homalozoa/librebd1/BD1.FCStd

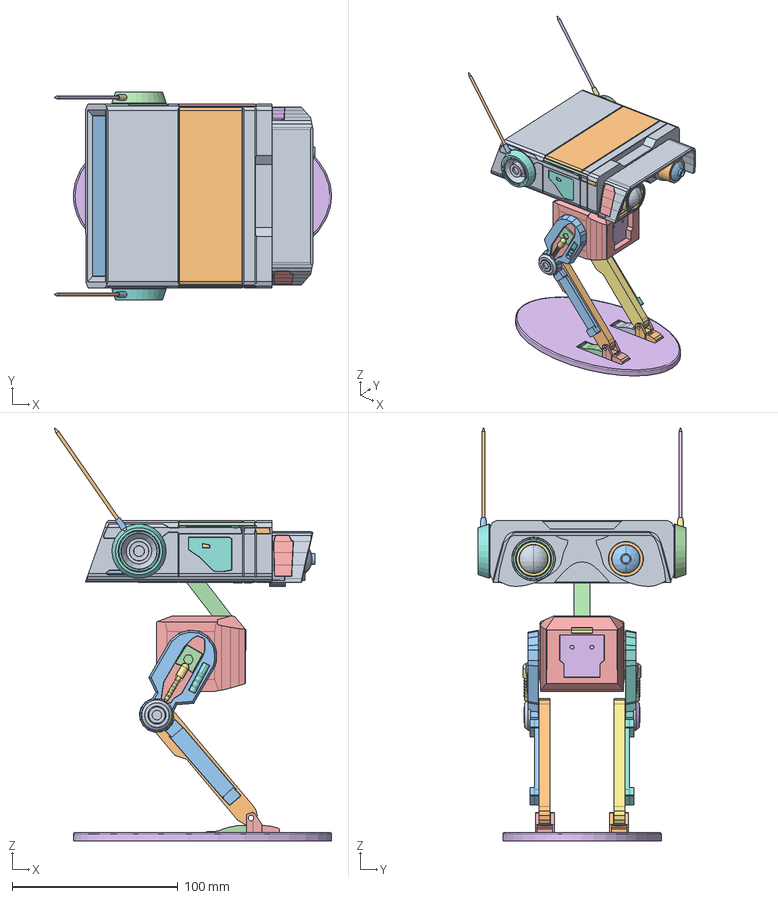
[picture p2: CAD file, 2026-10-29]
BD1.FCStd
167.5 x 125.7 x 249.4 mm
head_shell
head_top_band
head_light
paint_left_stripe
paint_left_top_edge
paint_left_hood_grey
paint_right_panel_dot
paint_right_panel
paint_right_stripe
paint_right_front_block
paint_right_back_strip
paint_right_top_edge
paint_right_snout
paint_right_hood_grey
eye_ring_right
eye_band_right
lens_right
eye_ring_left
lens_left
ear_left
ear_centre_left
antenna_left
antenna_collar_left
ear_right
ear_centre_right
antenna_right
antenna_collar_right
neck
torso
chest_plate
chest_tab
thigh_left
thigh_channel_left
thigh_channel_floor_left
thigh_channel_tip_left
thigh_rod_left
thigh_piston_left
knee_cap_left
shin_left
shin_plate_left
foot_heel_left
foot_front_left
thigh_right
thigh_channel_right
thigh_channel_floor_right
thigh_channel_tip_right
thigh_rod_right
thigh_piston_right
knee_cap_right
shin_right
shin_plate_right
foot_heel_right
foot_front_right
stand
