homalozoa/librebd1/stl/foot_front_left.stl

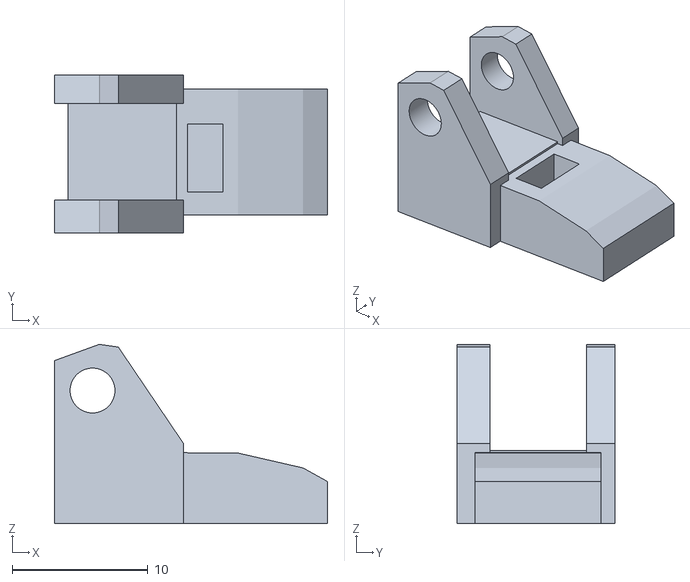
[picture p3: CAD file, 2026-10-29]
stl/foot_front_left.stl
20.1 x 11.6 x 13.2
