homalozoa/librebd1/stl/shin_plate_left.stl

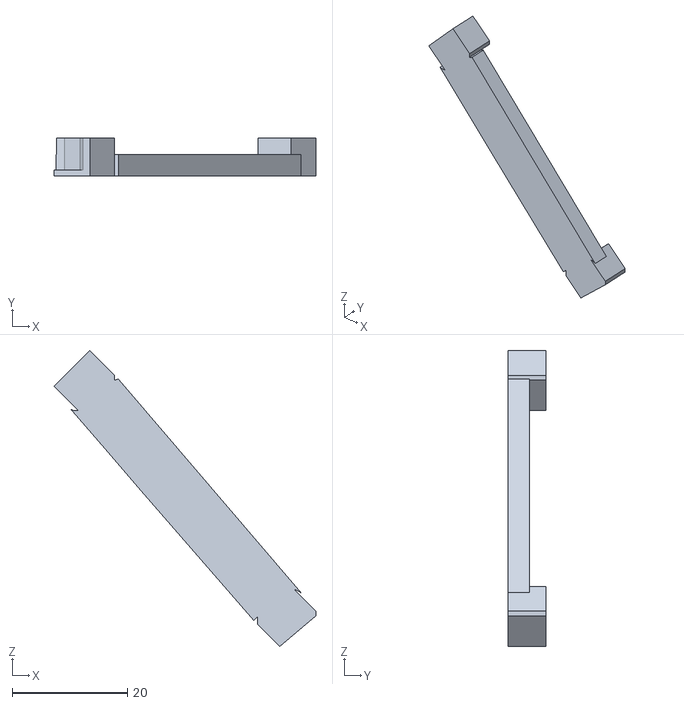
[picture p4: CAD file, 2026-10-29]
stl/shin_plate_left.stl
45.5 x 6.60 x 51.5
