homalozoa/librebd1/stl/neck.stl

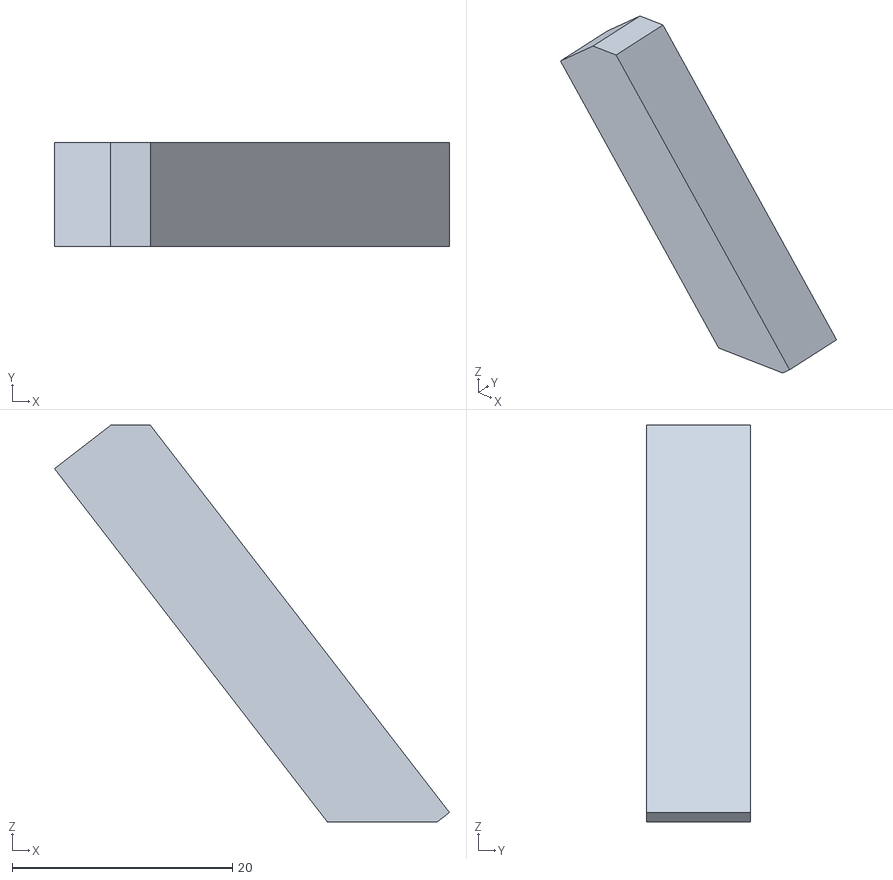
[picture p5: CAD file, 2026-10-29]
stl/neck.stl
35.9 x 9.40 x 36.0
