homalozoa/librebd1/stl/chest_plate.stl

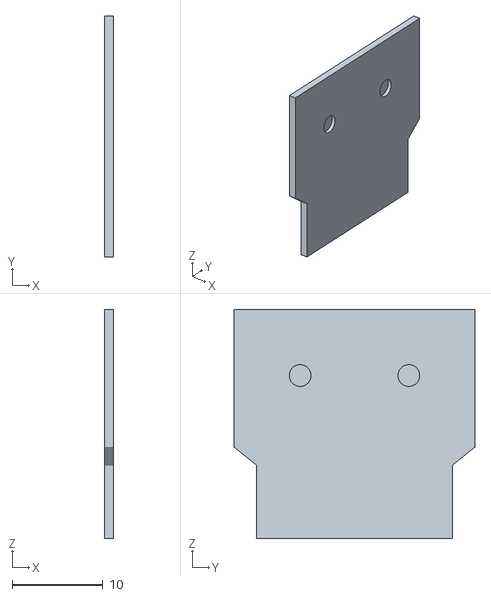
[picture p6: CAD file, 2026-10-29]
stl/chest_plate.stl
1.00 x 26.6 x 25.3
