homalozoa/librebd1/stl/eye_band_right.stl

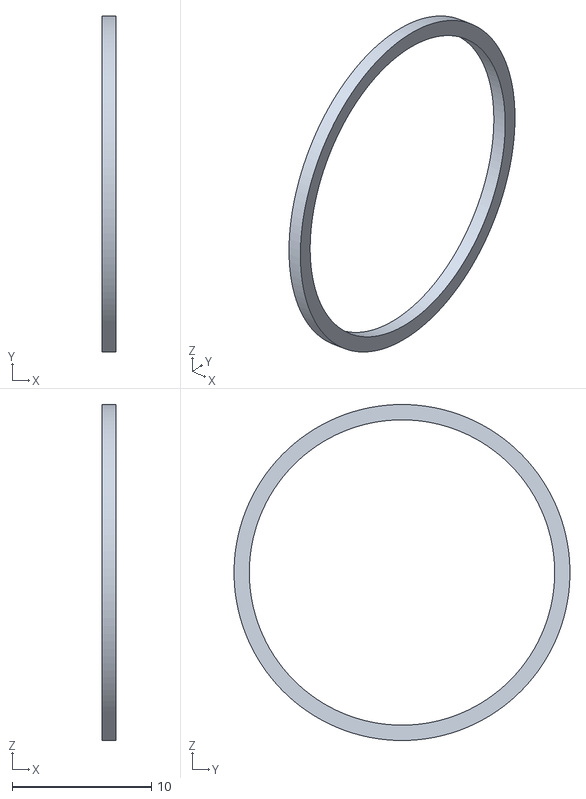
[picture p7: CAD file, 2026-10-29]
stl/eye_band_right.stl
1.00 x 24.1 x 24.1
