homalozoa/librebd1/stl/paint_left_hood_grey.stl

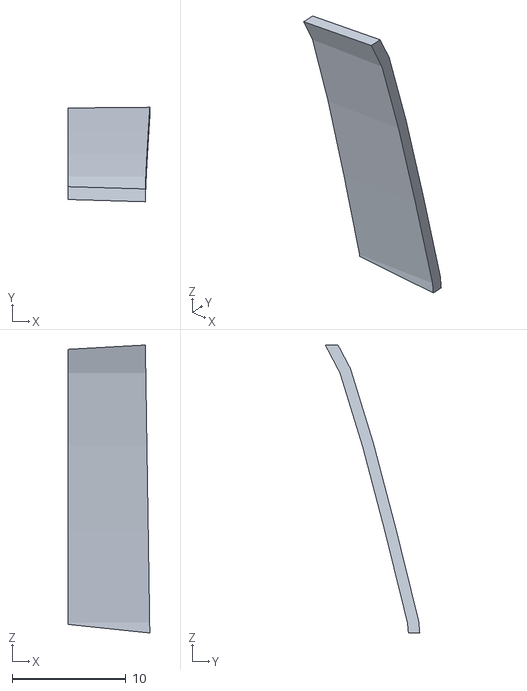
[picture p8: CAD file, 2026-10-29]
stl/paint_left_hood_grey.stl
7.20 x 8.33 x 25.4
