homalozoa/librebd1/stl/shin_left.stl

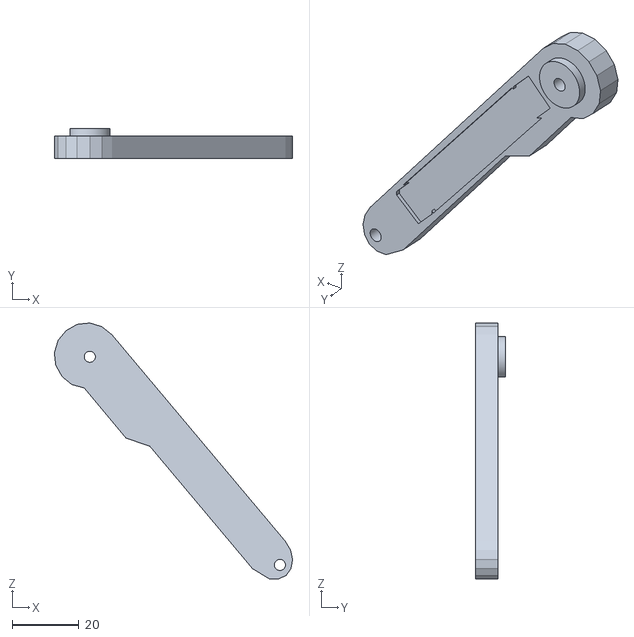
[picture p9: CAD file, 2026-10-29]
stl/shin_left.stl
71.2 x 8.84 x 76.5
