homalozoa/librebd1/stl/thigh_channel_right.stl

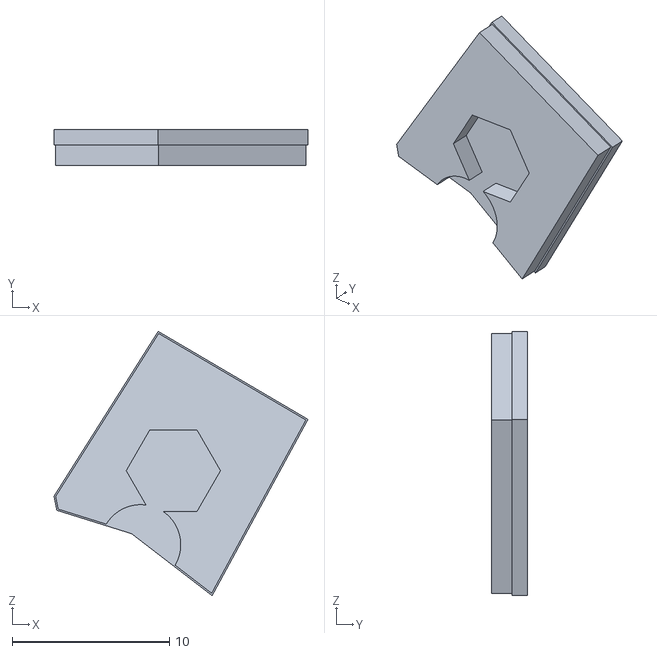
[picture p10: CAD file, 2026-10-29]
stl/thigh_channel_right.stl
16.2 x 2.30 x 16.8
