homalozoa/librebd1/stl/ear_right.stl

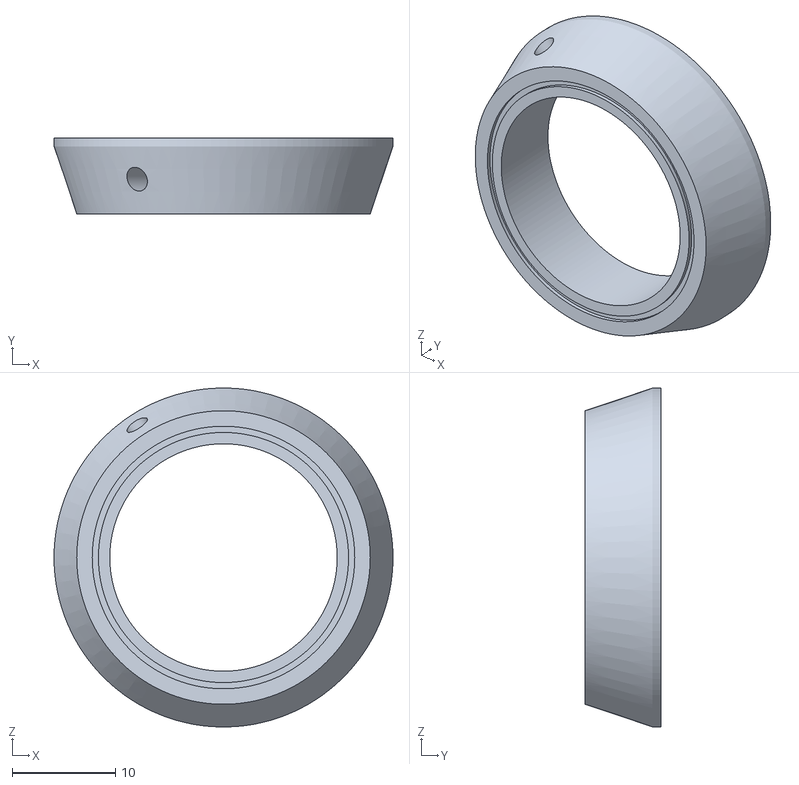
[picture p11: CAD file, 2026-10-29]
stl/ear_right.stl
32.8 x 7.35 x 32.8
