homalozoa/librebd1/stl/foot_heel_right.stl

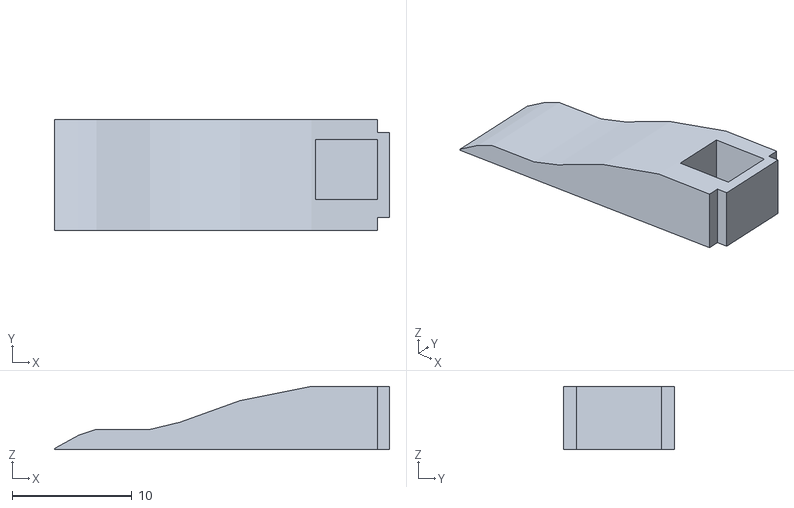
[picture p12: CAD file, 2026-10-29]
stl/foot_heel_right.stl
28.0 x 9.30 x 5.30
