homalozoa/librebd1/stl/torso.stl

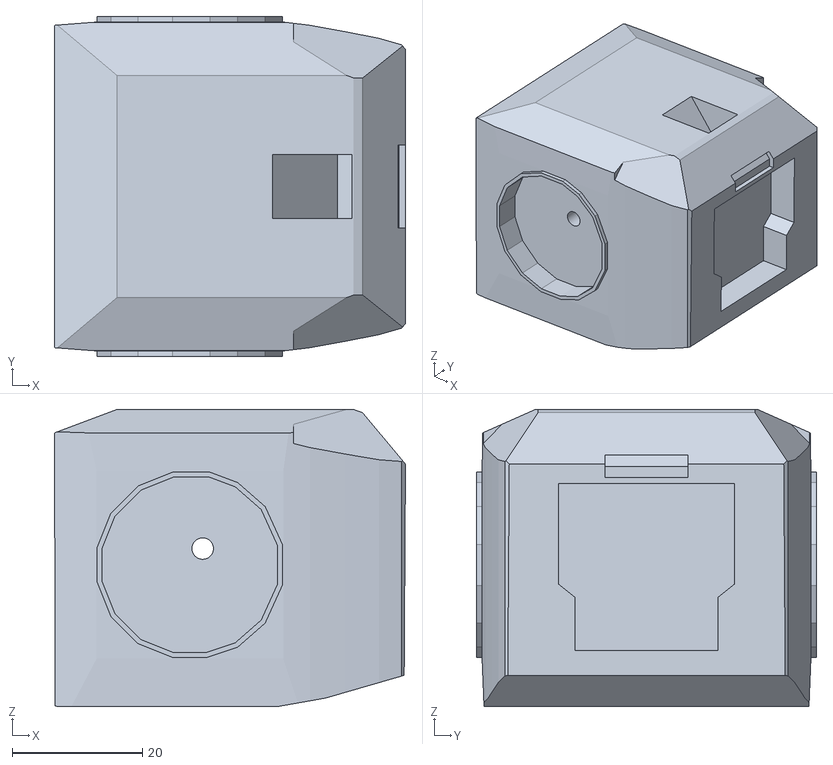
[picture p13: CAD file, 2026-10-29]
stl/torso.stl
54.0 x 52.3 x 45.7
