homalozoa/librebd1/stl/paint_right_hood_grey.stl

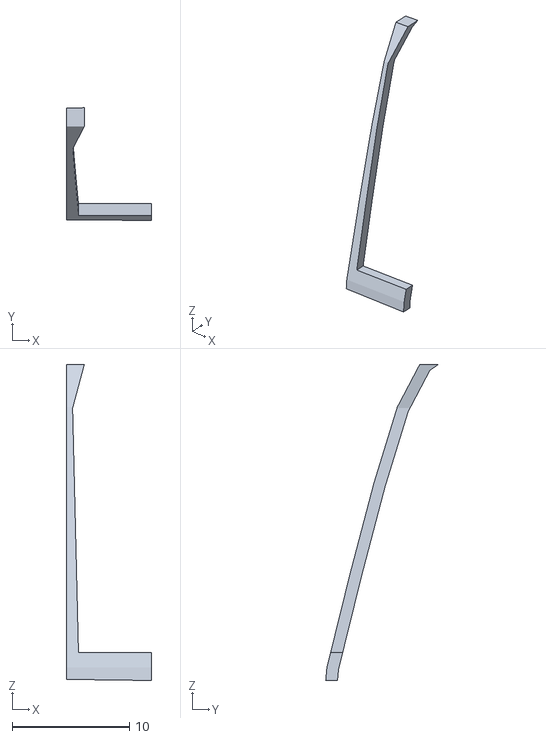
[picture p14: CAD file, 2026-10-29]
stl/paint_right_hood_grey.stl
7.20 x 9.59 x 26.9
