homalozoa/librebd1/stl/ear_centre_left.stl

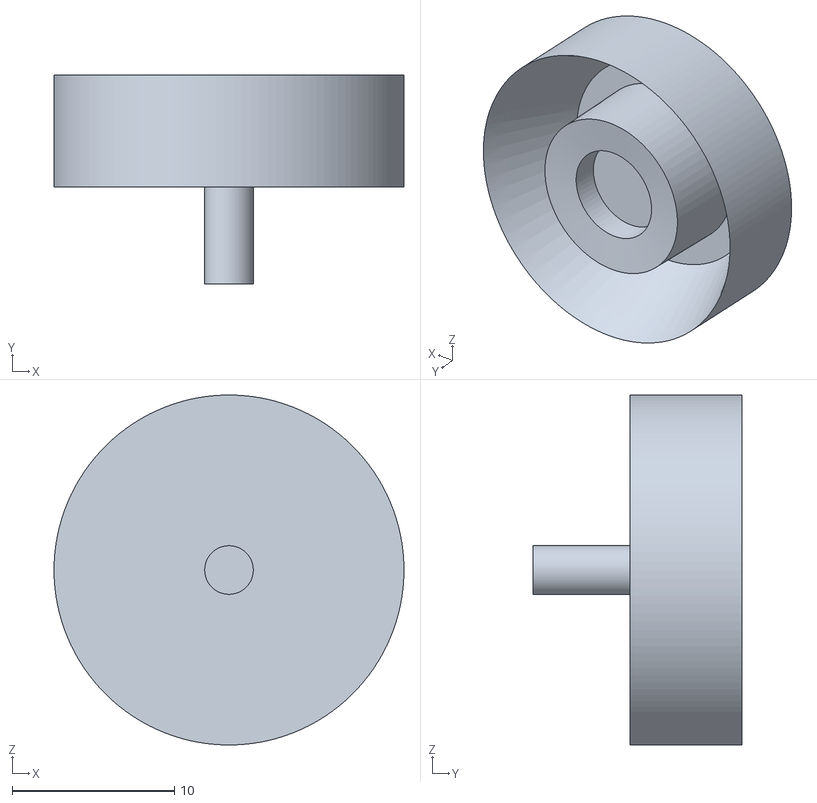
[picture p15: CAD file, 2026-10-29]
stl/ear_centre_left.stl
21.6 x 12.9 x 21.6
