homalozoa/librebd1/stl/thigh_piston_right.stl

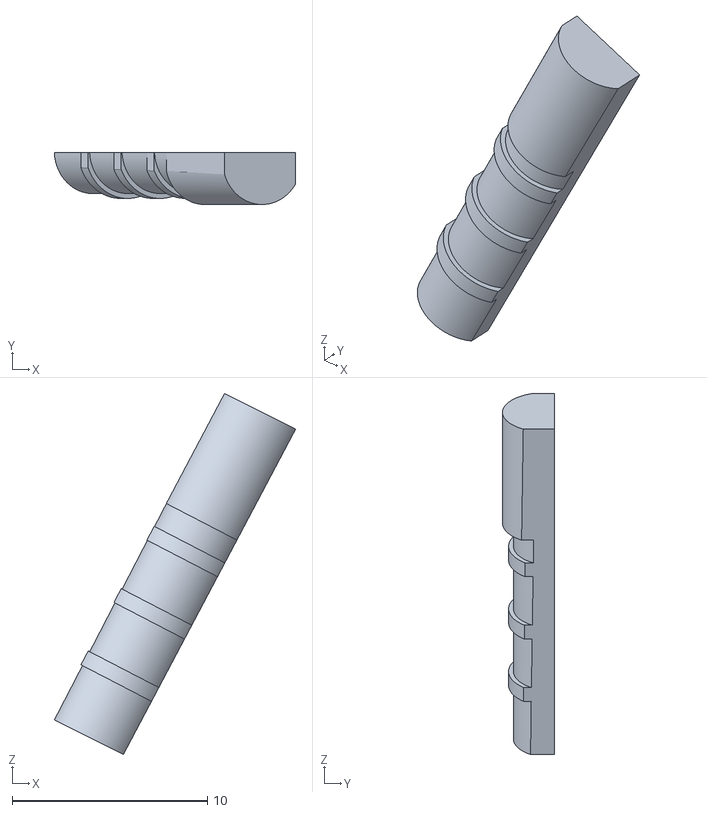
[picture p16: CAD file, 2026-10-29]
stl/thigh_piston_right.stl
12.3 x 2.66 x 18.5
