homalozoa/librebd1/stl/antenna_collar_right.stl

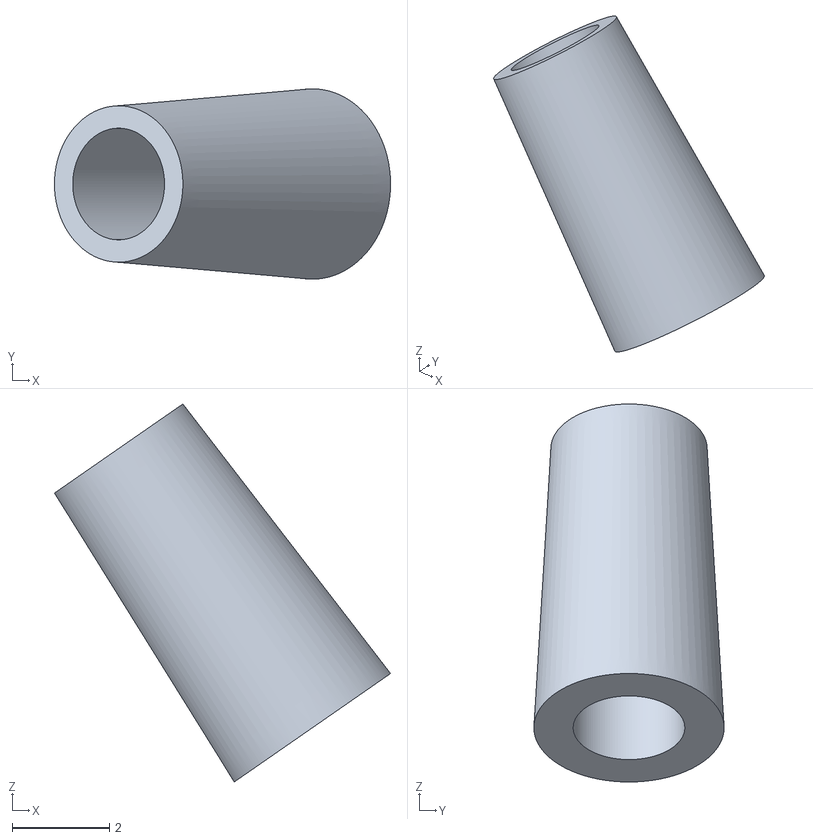
[picture p17: CAD file, 2026-10-29]
stl/antenna_collar_right.stl
6.92 x 3.92 x 7.79
