homalozoa/librebd1/stl/knee_cap_right.stl

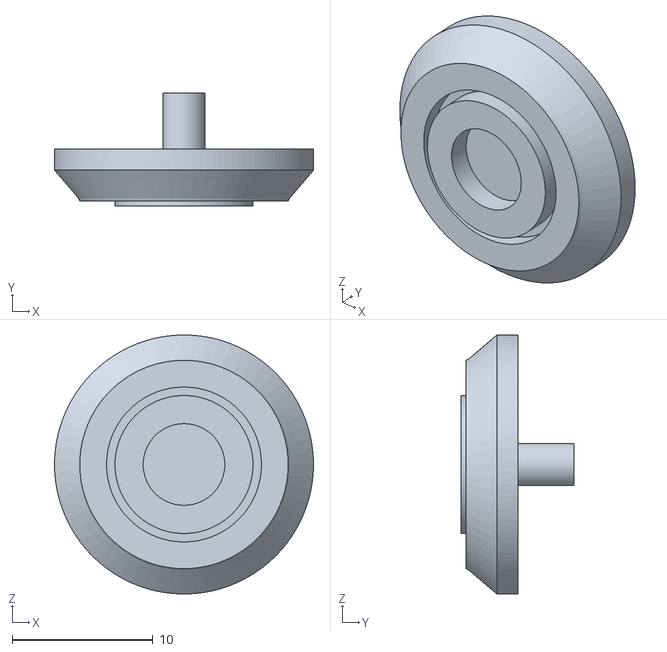
[picture p18: CAD file, 2026-10-29]
stl/knee_cap_right.stl
18.4 x 8.06 x 18.4
