homalozoa/librebd1/stl/paint_right_panel.stl

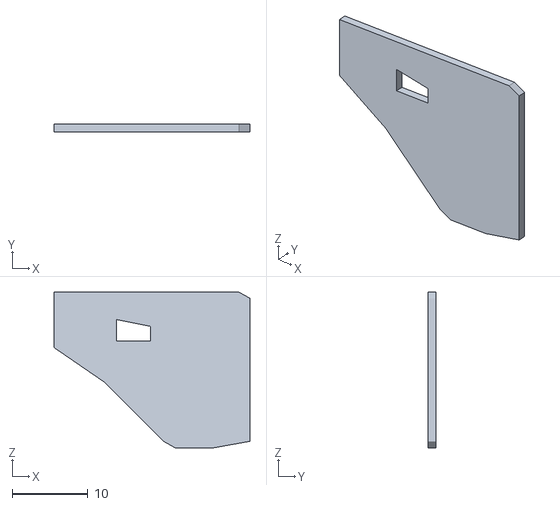
[picture p19: CAD file, 2026-10-29]
stl/paint_right_panel.stl
25.8 x 1.00 x 20.5
