homalozoa/librebd1/stl/paint_left_stripe.stl

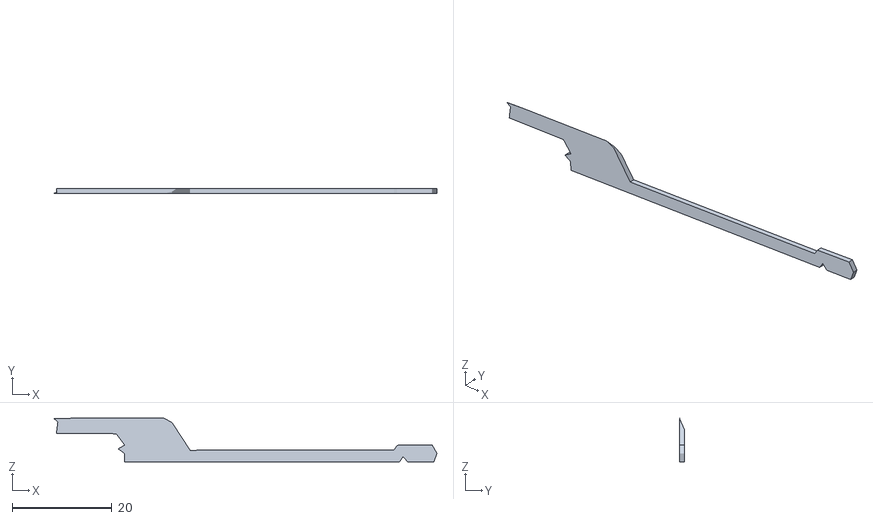
[picture p20: CAD file, 2026-10-29]
stl/paint_left_stripe.stl
76.6 x 1.00 x 8.71
