homalozoa/librebd1/stl/thigh_channel_floor_right.stl

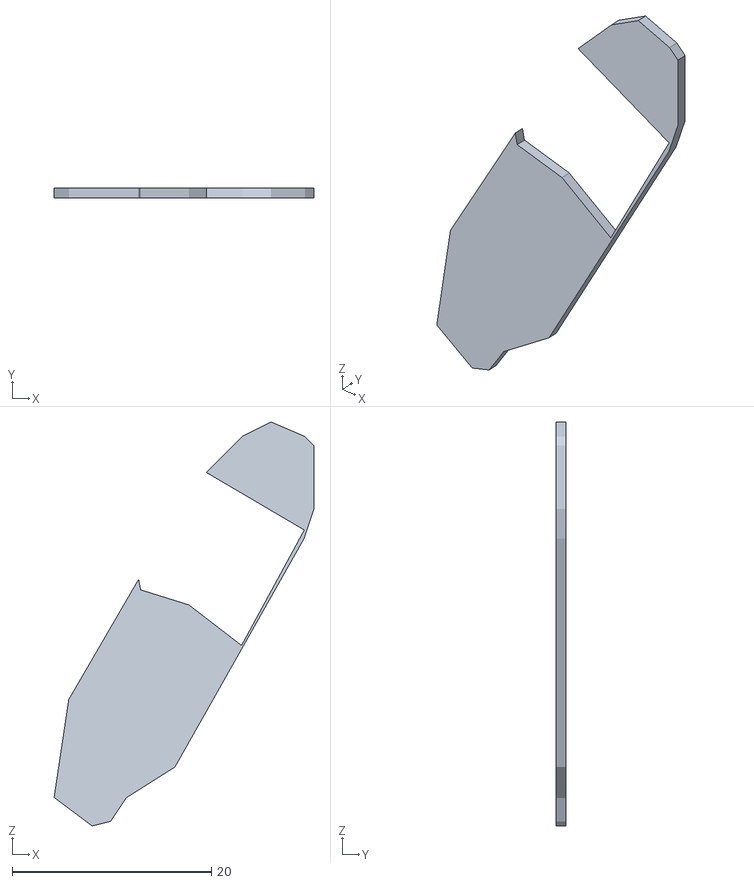
[picture p21: CAD file, 2026-10-29]
stl/thigh_channel_floor_right.stl
26.1 x 1.00 x 40.6
