homalozoa/librebd1/stl/head_shell.stl

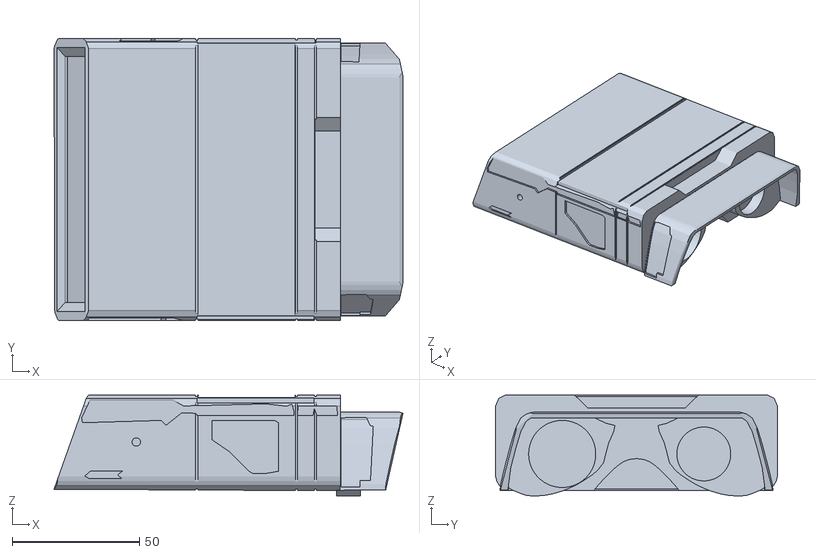
[picture p22: CAD file, 2026-10-29]
stl/head_shell.stl
137.4 x 111.0 x 39.8
