homalozoa/librebd1/stl/paint_right_stripe.stl

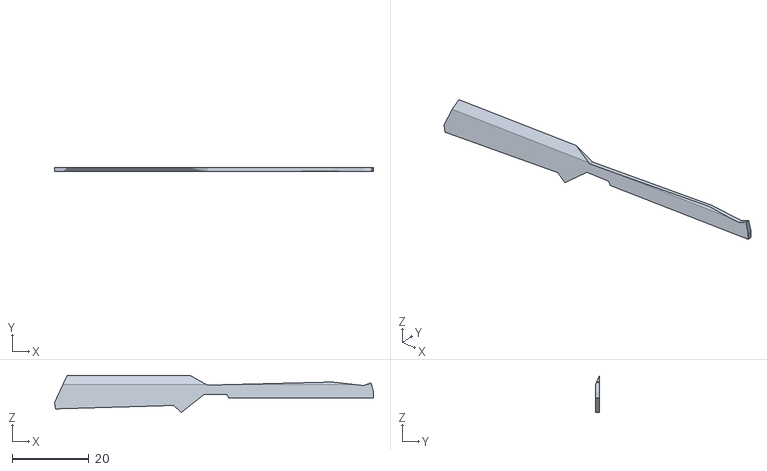
[picture p23: CAD file, 2026-10-29]
stl/paint_right_stripe.stl
83.1 x 1.00 x 9.64
