homalozoa/librebd1/stl/lens_right.stl

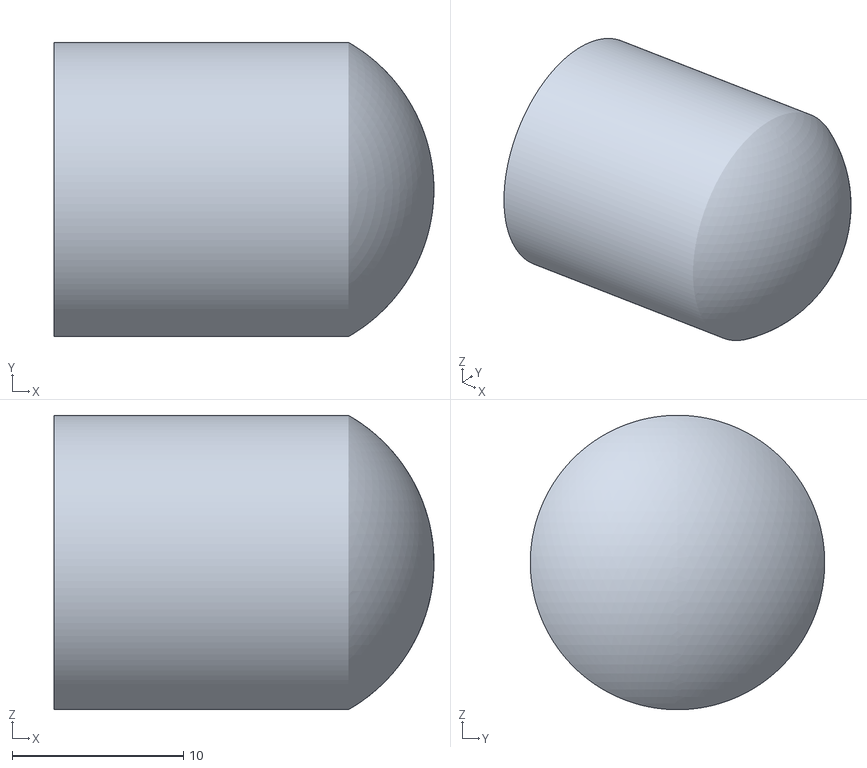
[picture p24: CAD file, 2026-10-29]
stl/lens_right.stl
22.2 x 17.2 x 17.2
