homalozoa/librebd1/stl/stand.stl

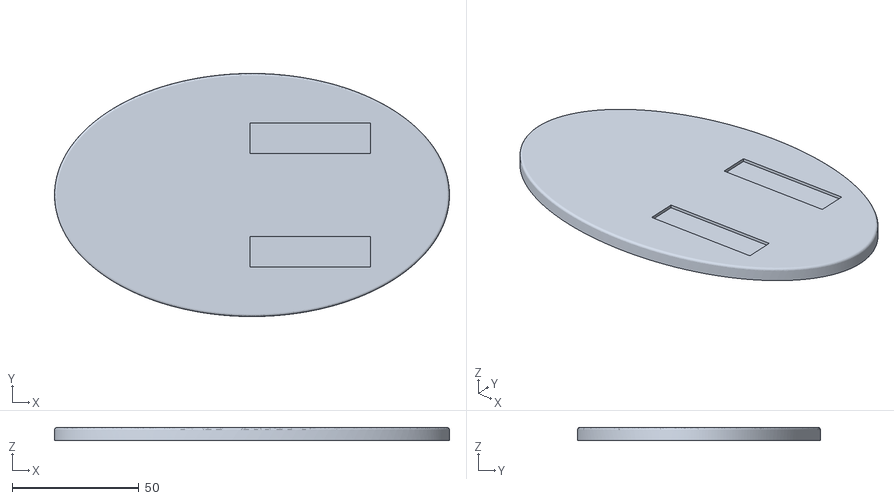
[picture p25: CAD file, 2026-10-29]
stl/stand.stl
156.0 x 96.0 x 5.20
