homalozoa/librebd1/stl/eye_ring_right.stl

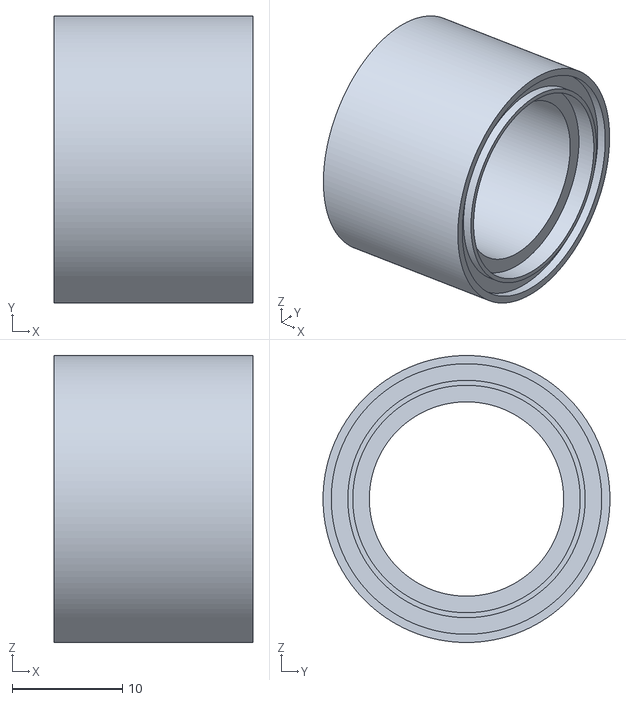
[picture p26: CAD file, 2026-10-29]
stl/eye_ring_right.stl
18.0 x 26.0 x 26.0
