homalozoa/librebd1/stl/head_top_band.stl

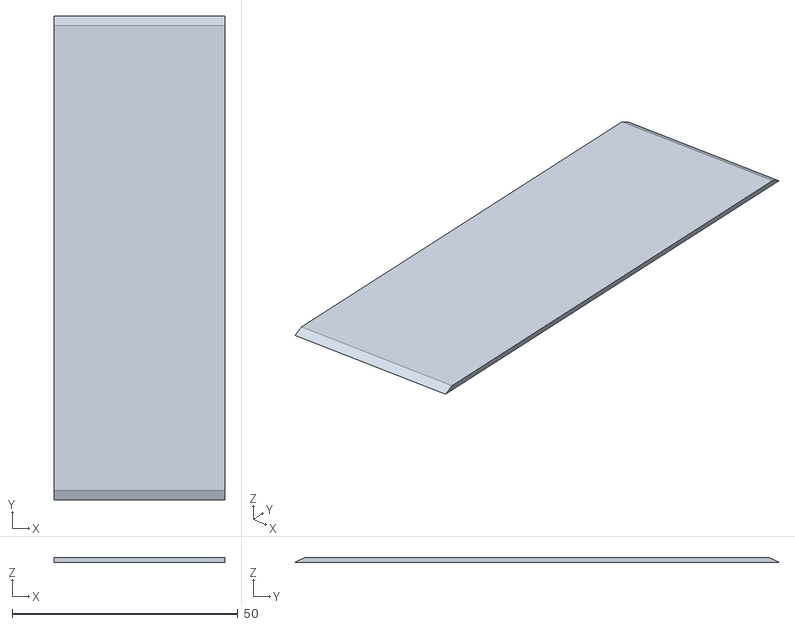
[picture p27: CAD file, 2026-10-29]
stl/head_top_band.stl
37.8 x 107.2 x 1.00
