homalozoa/librebd1/stl/paint_right_panel_dot.stl

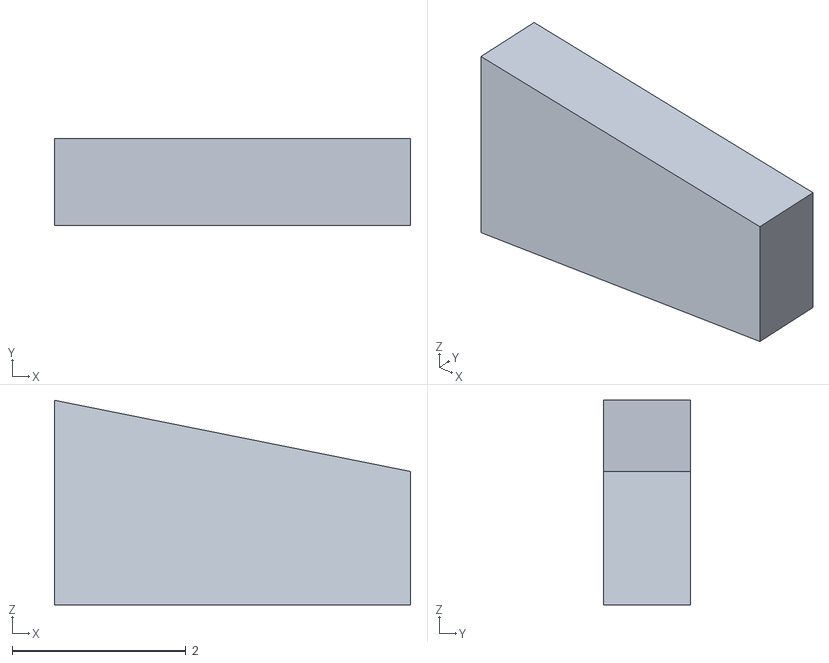
[picture p28: CAD file, 2026-10-29]
stl/paint_right_panel_dot.stl
4.10 x 1.00 x 2.36
