homalozoa/librebd1/stl/thigh_rod_left.stl

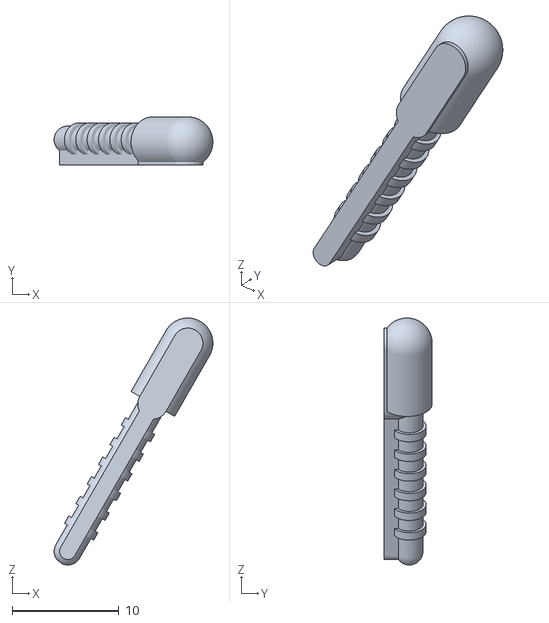
[picture p29: CAD file, 2026-10-29]
stl/thigh_rod_left.stl
14.9 x 4.52 x 23.1
