homalozoa/librebd1/stl/thigh_channel_tip_left.stl

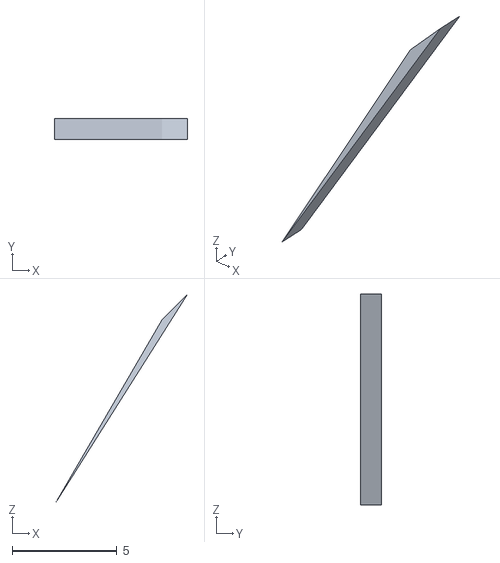
[picture p30: CAD file, 2026-10-29]
stl/thigh_channel_tip_left.stl
6.37 x 1.00 x 10.1
