homalozoa/librebd1/stl/paint_right_front_block.stl

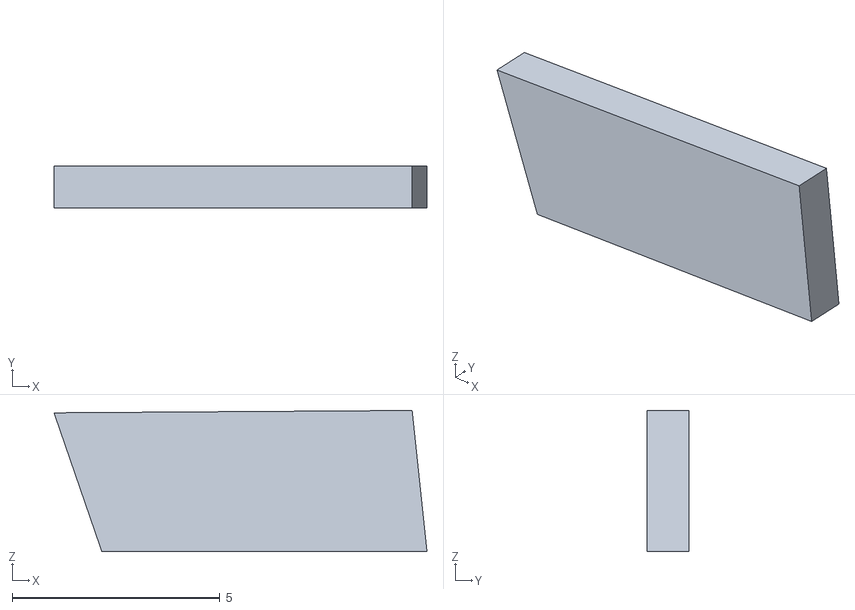
[picture p31: CAD file, 2026-10-29]
stl/paint_right_front_block.stl
8.99 x 1.00 x 3.40
