homalozoa/librebd1/stl/antenna_left.stl

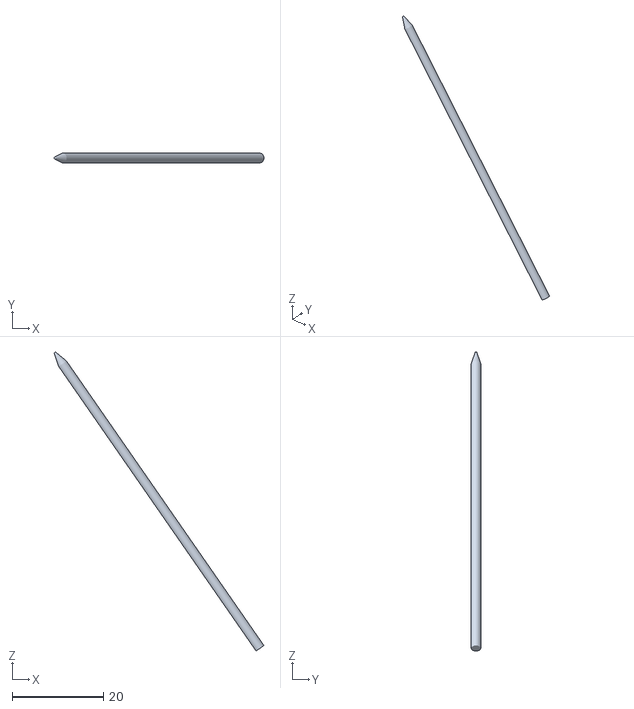
[picture p32: CAD file, 2026-10-29]
stl/antenna_left.stl
45.9 x 2.10 x 65.4
