homalozoa/librebd1/stl/head_light.stl

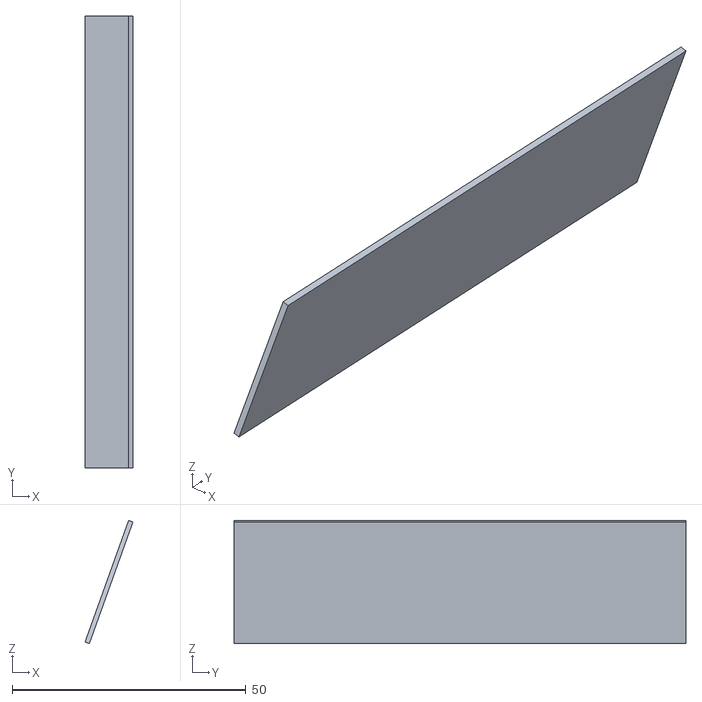
[picture p33: CAD file, 2026-10-29]
stl/head_light.stl
10.3 x 96.6 x 26.3
