homalozoa/librebd1/stl/paint_left_top_edge.stl

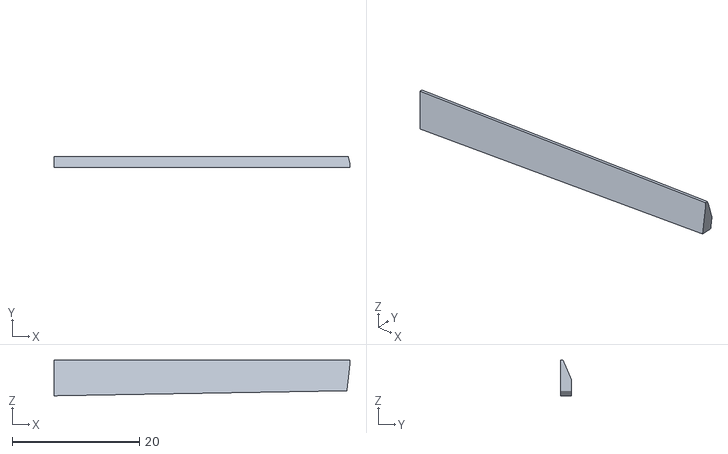
[picture p34: CAD file, 2026-10-29]
stl/paint_left_top_edge.stl
46.5 x 1.70 x 5.60
