homalozoa/librebd1/stl/lens_left.stl

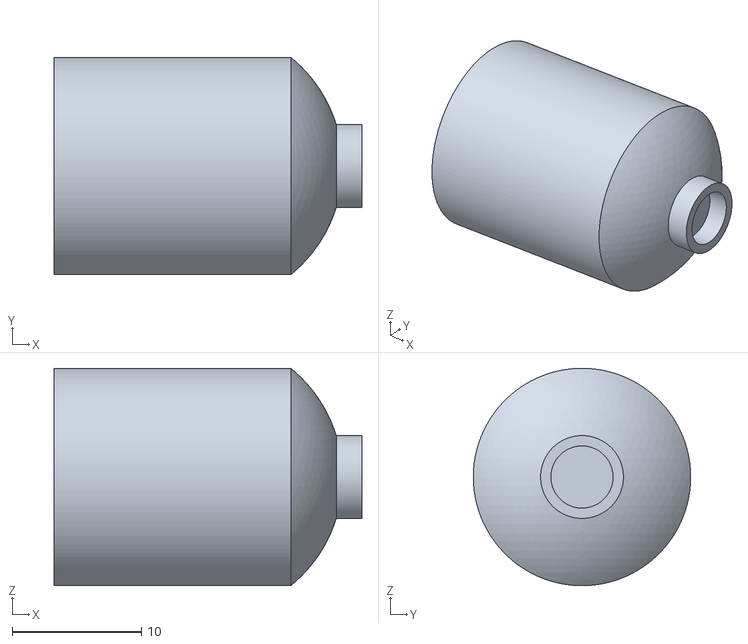
[picture p35: CAD file, 2026-10-29]
stl/lens_left.stl
23.8 x 16.8 x 16.8
