homalozoa/librebd1/stl/eye_ring_left.stl

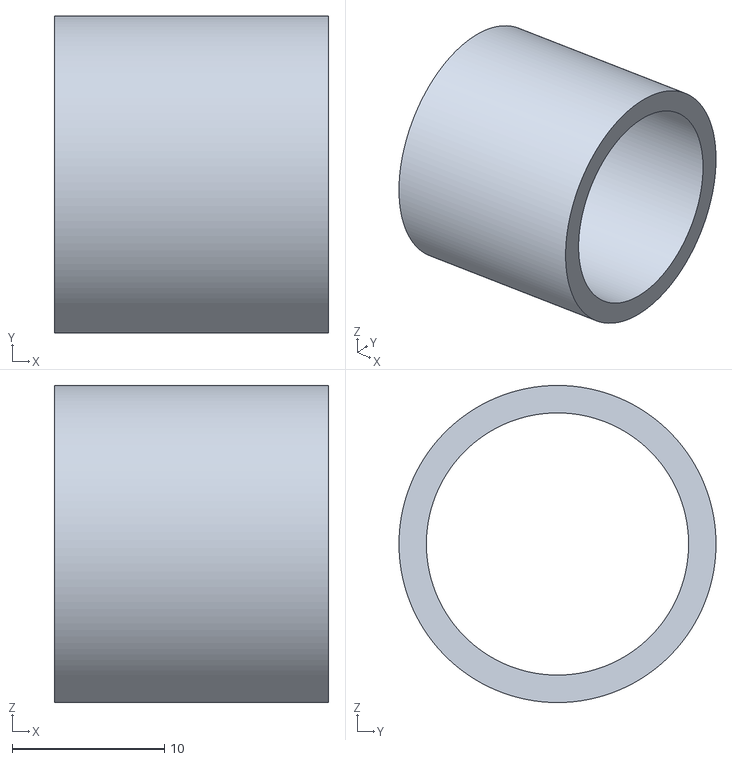
[picture p36: CAD file, 2026-10-29]
stl/eye_ring_left.stl
18.0 x 20.8 x 20.8
