homalozoa/librebd1/stl/paint_right_top_edge.stl

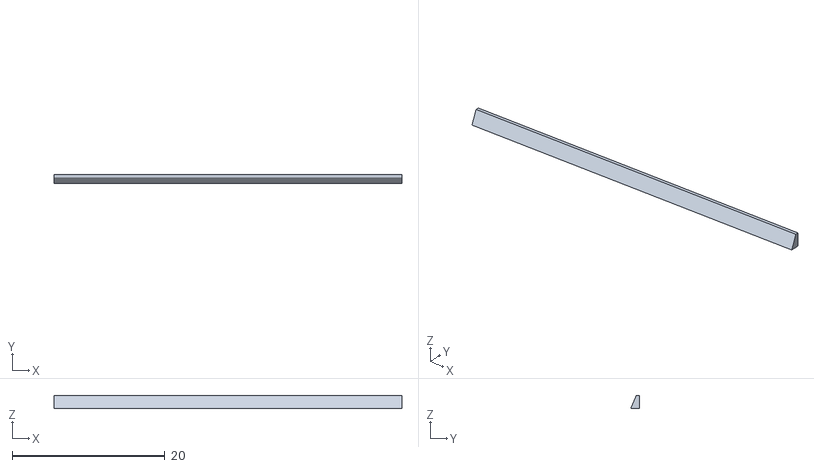
[picture p37: CAD file, 2026-10-29]
stl/paint_right_top_edge.stl
45.6 x 1.14 x 1.70
