homalozoa/librebd1/stl/paint_right_back_strip.stl

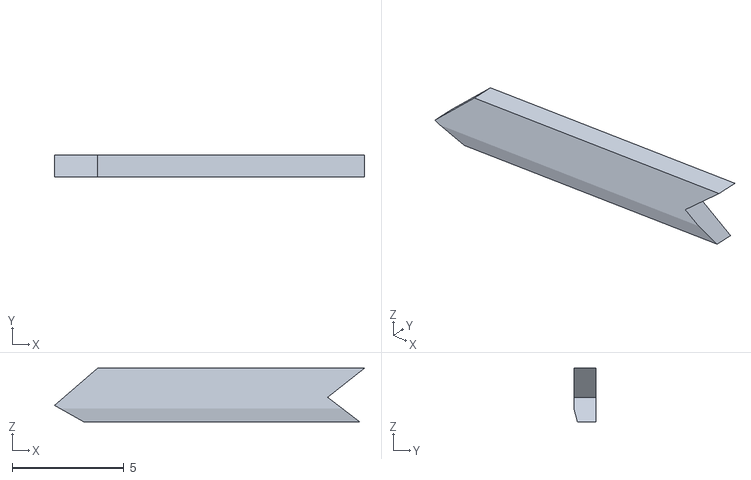
[picture p38: CAD file, 2026-10-29]
stl/paint_right_back_strip.stl
13.9 x 1.00 x 2.40
