homalozoa/librebd1/stl/paint_right_snout.stl

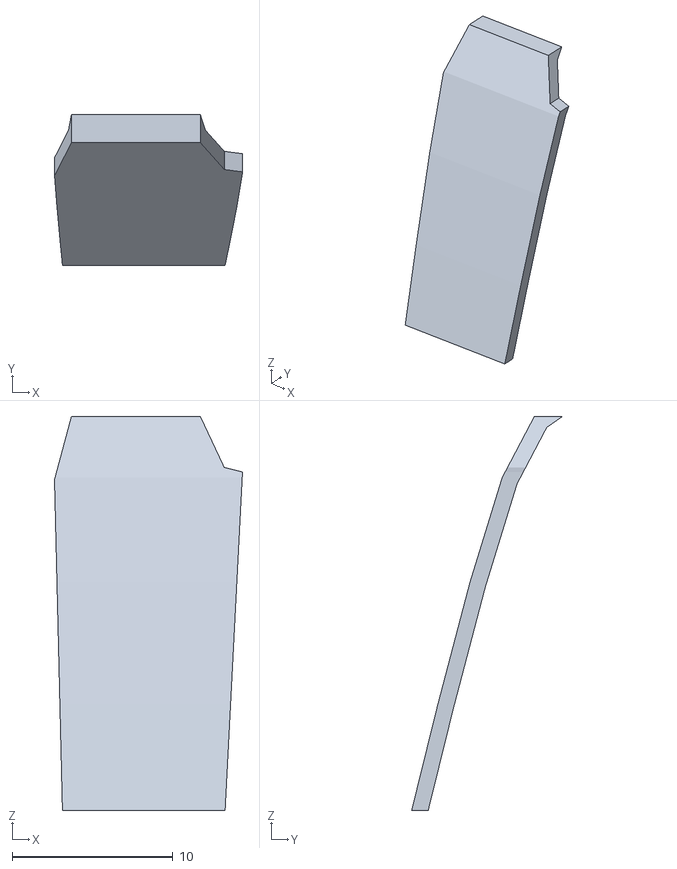
[picture p39: CAD file, 2026-10-29]
stl/paint_right_snout.stl
11.7 x 9.37 x 24.5
