homalozoa/librebd1/stl/chest_tab.stl

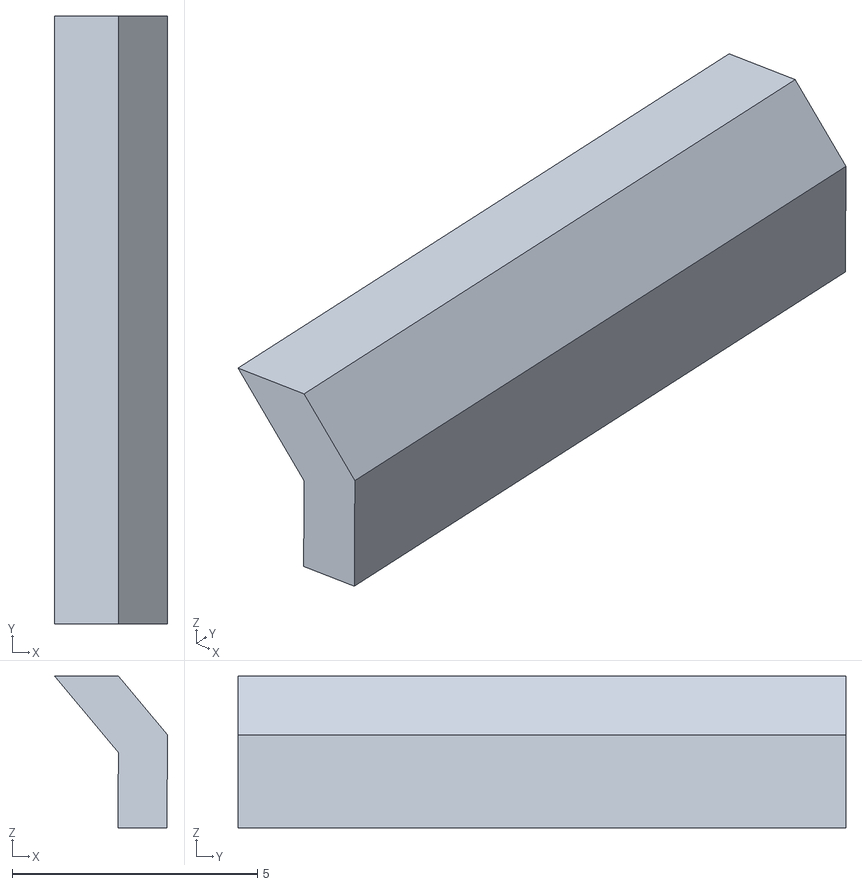
[picture p40: CAD file, 2026-10-29]
stl/chest_tab.stl
2.31 x 12.4 x 3.10
