homalozoa/librebd1/stl/thigh_left.stl

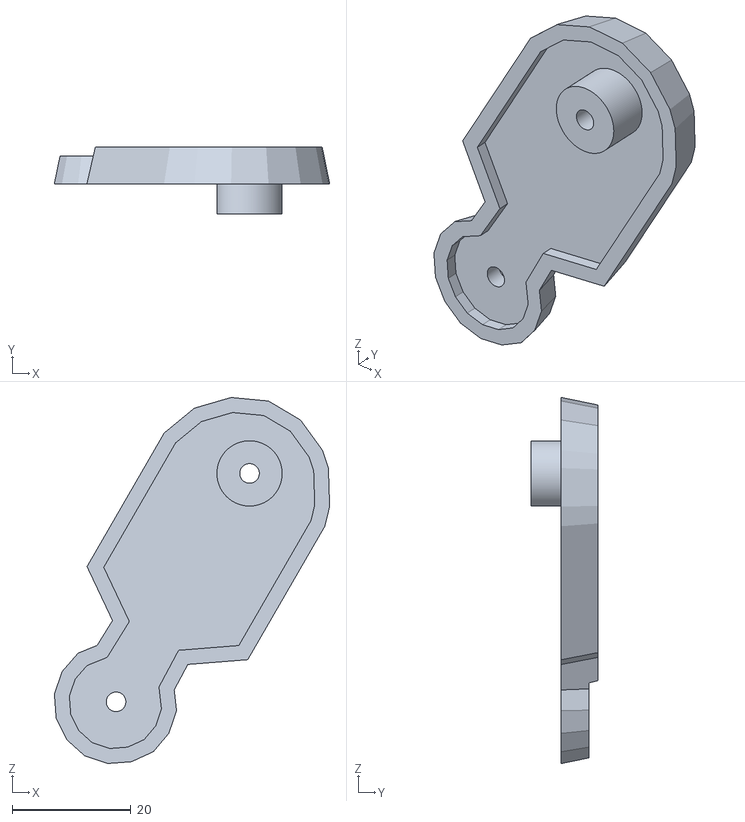
[picture p41: CAD file, 2026-10-29]
stl/thigh_left.stl
46.4 x 11.3 x 61.7
