homalozoa/librebd1/(list of files, cad)

Other CAD files:
stl/shin_plate_right.stl
stl/foot_front_right.stl
stl/foot_heel_left.stl
stl/thigh_channel_left.stl
stl/knee_cap_left.stl
stl/ear_left.stl
stl/thigh_channel_floor_left.stl
stl/ear_centre_right.stl
stl/antenna_collar_left.stl
stl/shin_right.stl
stl/antenna_right.stl
stl/thigh_piston_left.stl
stl/thigh_right.stl
stl/thigh_channel_tip_right.stl
stl/thigh_rod_right.stl
