homalozoa/librebd1/PRINTING.en.md

# Printing and assembly guide

[中文](PRINTING.md) · English

`stl/` holds 54 parts, one STL each, at the default head-top height of 190 mm. The STL coordinates are the assembled positions, so you have to lay each part flat in your slicer; the orientations are below. The fit clearances between parts were set for FDM printing with a 0.4 mm nozzle and have not been tried on SLA.

> The orientations and settings on this page are suggestions computed from the model geometry. They have not been verified by actually printing. For a first print, try the small parts before the head shell to check the fits, then print the large ones.

## Preparation

**Materials and tools**

| Item | Spec | Used for |
|---|---|---|
| Steel rod, aluminium rod or M3 screws | 3 mm | Hip pin 1 × 3×65 mm; knee pins 2 × 3×8 mm; ankle pins 2 × 3×12 mm |
| Brass rod | 2 mm, about 76 mm each, 2 in all | Antennae (the printed antenna is only 2.1 mm thick and breaks easily, so treat it as a spare) |
| CA glue or two-part epoxy | | All inlays, the small pieces inside the thigh, the feet |
| Primer, ivory spray paint, dark grey panel-line wash | | Painting (not needed if you just print in colours) |
| Small drill bits | 3.3 mm, 2.3 mm | Opening up holes that print too tight |

**Print settings (suggested)**

- 0.4 mm nozzle, PLA is fine. Use 0.12–0.16 mm layers for small parts and thin inlays. For clear threads on the rods and threaded pistons, use a 0.2 mm nozzle or 0.08 mm layers.
- Large parts such as the head shell: 2–3 walls, 10–15 % infill.
- The default height is 190 mm. For close to life size, export with `BD1_HEIGHT=316` (see the README). Pin holes and glue gaps keep their size, so the hardware does not change.
- Print one 1 mm inlay (for example `paint_right_panel`) first and try it in the pocket in the head shell. If the 0.2 mm glue gap per side is too tight or too loose, that is your printer's tolerance. Adjust the horizontal expansion setting, or change the gap in `bd1_model.py` and export again.

## Parts list

Every part has been turned to the orientation with the least overhang, and the images and the table below show that result (generated by `render_print_layout.py`, which recomputes it). In the images the grey is the print bed, and each title gives the print height and the overhang area. Overhang area means faces that tilt downward more than 45° and are not on the bed; parts with large values need support. To see it in 3D, open the web page (see the "Web page" section of the README) and switch to the print beds.

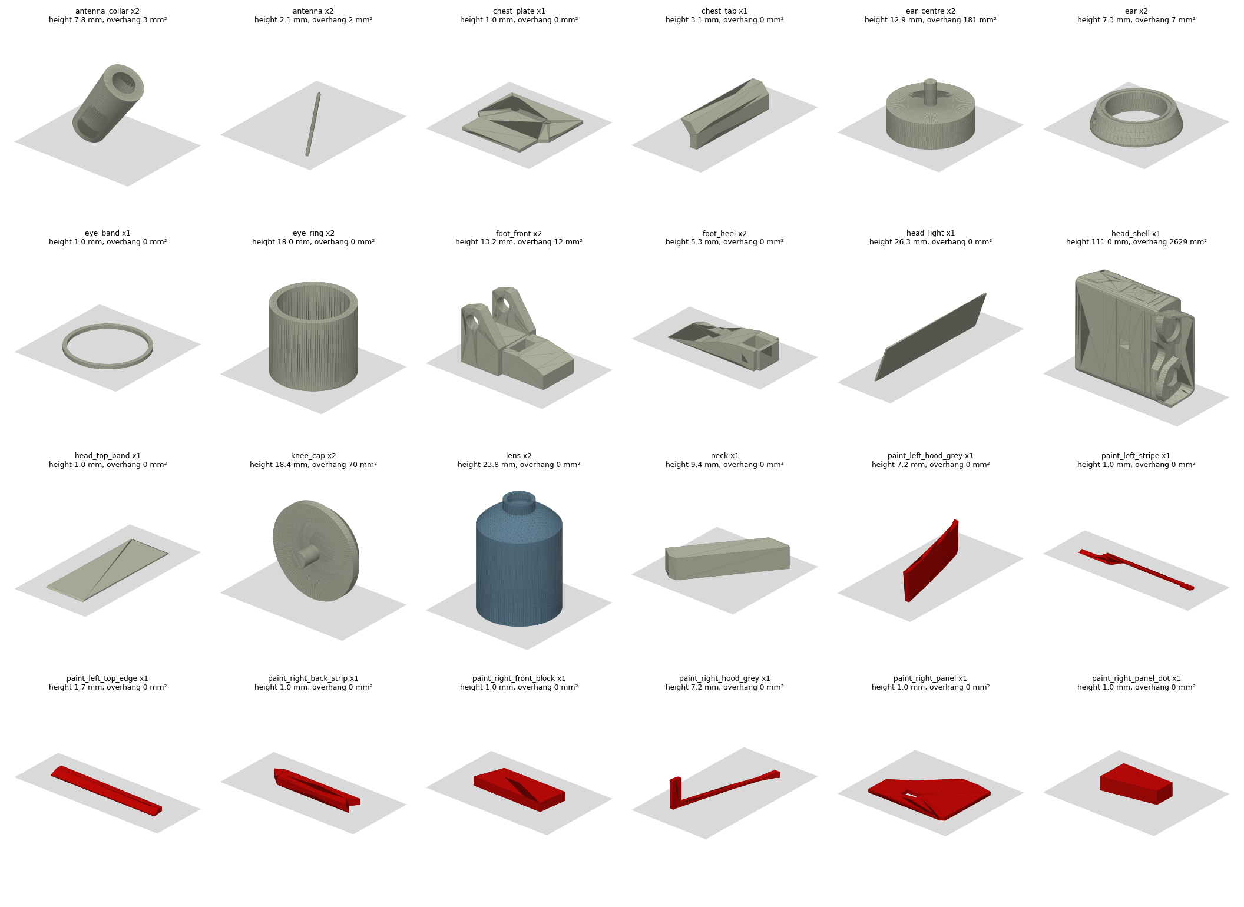
[picture p42: images/print_layout_1.png]
Print orientations 1

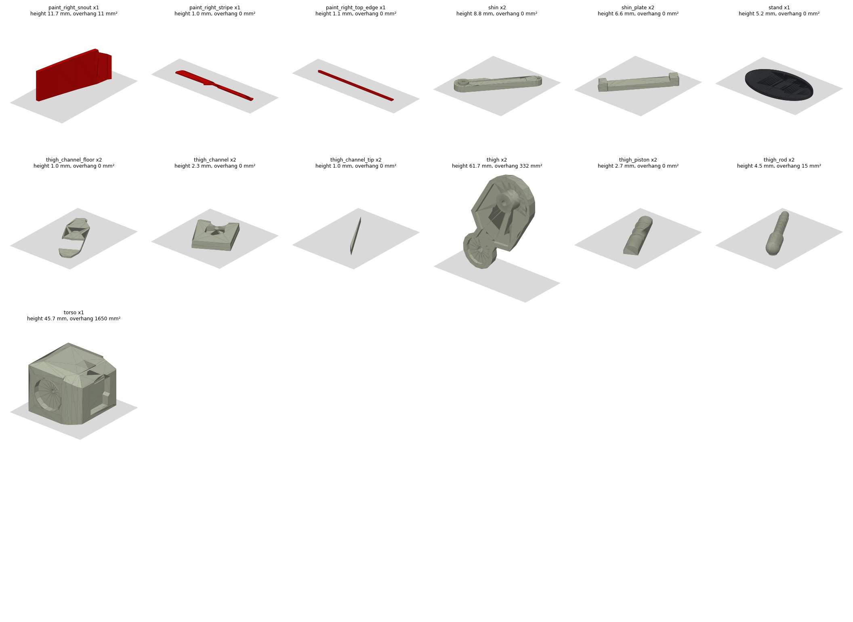
[picture p43: images/print_layout_2.png]
Print orientations 2


Quantities include both left and right parts. Colours are given by name such as "Ivory", or you can print everything white and paint it by hand. Parts with more than 150 mm² of overhang are marked as needing support. This is only a geometric estimate and has not been checked against any particular slicer; trust your slicer's preview.

| Part | Qty | Colour | Print height mm | Overhang mm² | Support |
|---|---|---|---|---|---|
| `antenna` Antenna | 2 | Ivory | 2.1 | 2 | little or none |
| `antenna_collar` Antenna collar | 2 | Charcoal | 7.79 | 3 | little or none |
| `ear` Ear ring | 2 | Warm ivory | 7.35 | 7 | little or none |
| `ear_centre` Ear centre | 2 | Mid grey | 12.9 | 181 | needed |
| `foot_front` Foot front | 2 | Pale sage | 13.2 | 12 | little or none |
| `head_shell` Head shell | 1 | Ivory | 111.0 | 2628 | needed |
| `knee_cap` Knee cap | 2 | Mid grey | 18.39 | 70 | little or none |
| `paint_right_snout` Side paint inlay | 1 | Bright red | 11.69 | 11 | little or none |
| `thigh` Thigh | 2 | Warm ivory | 61.7 | 332 | needed |
| `thigh_rod` Rod | 2 | Mid grey | 4.52 | 15 | little or none |
| `torso` Torso | 1 | Ivory | 45.7 | 1650 | needed |
| `chest_plate` Chest plate | 1 | Grey | 1.0 | 0 | little or none |
| `chest_tab` Chest tab | 1 | Dark red | 3.1 | 0 | little or none |
| `eye_band` Right-eye ring | 1 | Bright red | 1.0 | 0 | little or none |
| `eye_ring` Eye barrel | 2 | Light grey | 18.0 | 0 | little or none |
| `foot_heel` Foot heel | 2 | Dark grey | 5.3 | 0 | little or none |
| `head_light` Light panel | 1 | Green | 26.32 | 0 | little or none |
| `head_top_band` Top band | 1 | Grey | 1.0 | 0 | little or none |
| `lens` Lens | 2 | Lens grey | 23.8 | 0 | little or none |
| `neck` Neck | 1 | Ivory | 9.4 | 0 | little or none |
| `paint_left_hood_grey` Side paint inlay | 1 | Grey | 7.2 | 0 | little or none |
| `paint_left_stripe` Side paint inlay | 1 | Bright red | 1.0 | 0 | little or none |
| `paint_left_top_edge` Side paint inlay | 1 | Grey | 1.7 | 0 | little or none |
| `paint_right_back_strip` Side paint inlay | 1 | Bright red | 1.0 | 0 | little or none |
| `paint_right_front_block` Side paint inlay | 1 | Bright red | 1.0 | 0 | little or none |
| `paint_right_hood_grey` Side paint inlay | 1 | Grey | 7.2 | 0 | little or none |
| `paint_right_panel` Side paint inlay | 1 | Grey | 1.0 | 0 | little or none |
| `paint_right_panel_dot` Side paint inlay | 1 | Bright red | 1.0 | 0 | little or none |
| `paint_right_stripe` Side paint inlay | 1 | Bright red | 1.0 | 0 | little or none |
| `paint_right_top_edge` Side paint inlay | 1 | Grey | 1.14 | 0 | little or none |
| `shin` Shin | 2 | Warm grey | 8.84 | 0 | little or none |
| `shin_plate` Shin plate | 2 | Dark red | 6.6 | 0 | little or none |
| `stand` Stand | 1 | Black-grey | 5.2 | 0 | little or none |
| `thigh_channel` Channel block | 2 | Dark red | 2.3 | 0 | little or none |
| `thigh_channel_floor` Channel floor | 2 | Dark brown | 1.0 | 0 | little or none |
| `thigh_channel_tip` Channel tip | 2 | Dark brown | 1.0 | 0 | little or none |
| `thigh_piston` Threaded piston | 2 | Mid grey | 2.66 | 0 | little or none |

54 parts in all. Print time and filament use have not been measured, so no figures are given here.

## Assembly steps

1. **Dry fit**: without glue, put all the inlays into their pockets and check they sit flat. File lightly where one is tight; never force it.
2. **Head**
   1. Glue the top band, the paint_* pieces on both sides and the right-eye ring into the head shell, following the pocket directions. The red and grey blocks on the hood must follow its curved face. The right (-y) and left (+y) patterns differ, so don't swap them.
   2. Glue the light panel to the floor of the recess at the back of the head.
   3. Each eye barrel goes into its 6 mm deep socket in the face panel, then the lens goes into the barrel. The right eye is the large steel-blue lens; the left is light grey.
   4. Ears: the grey centre piece goes into the side of the head by its own 3 mm peg, then the outer ring slides over it and is glued to the head.
   5. Antennae: slide on the antenna_collar first, then push the brass rod into the slanted 2.3 mm hole on the outer ear ring.
3. **Torso**: glue the chest plate to the floor of the chest pocket, and the red chest tab where the front meets the sloped top.
4. **Neck**: each end goes into an 8 mm slanted hole (one in the head shell, one in the torso).
5. **Thighs**
   1. First fit the dark-brown channel floor, the small tip piece and the dark-red block into the channel.
   2. Glue the rod to the channel floor with its thick end below the hex pocket, and glue the threaded piston into the side slot.
   3. Press the knee cap into the knee recess.
6. **Shins**: the red plate goes into a 1 mm pocket and stands proud of the shin, with a lug at each end.
7. **Feet**: butt-glue the dark rear half and the light front half at x = 40.5, with the ankle fork on the front half.
8. **Joints** (held by friction only; do not glue)
   - **Hip**: the hub on the inside of each thigh reaches into the round recess on the side of the torso, and one 3×65 mm pin passes through the left thigh, the torso and the right thigh.
   - **Knee**: one 3×8 mm pin per side, inserted from the inside of the shin, with the outside plugged by the short peg on the knee cap.
   - **Ankle**: one 3×12 mm pin per side, through the fork on the foot and the end of the shin.
9. **Stand (required)**: glue both feet into the 1.2 mm recesses in the stand. The centre of mass is about 4.5 mm behind the heel, so two feet alone cannot stand.

## Painting

Prime first, then spray ivory. The red, grey and dark parts are all separate pieces, so no masking is needed. Draw a red line in the 0.6 mm groove on the outer ear ring. Finally fill the panel lines, the ear ring groove, the thigh side slot and the through-slots on the feet with dark grey panel-line wash. Dirt, scratches, gradients and colour patches smaller than about 3 mm exist only in the reference texture, so weathering has to be painted by hand.

## Matching Bambu Lab PLA Basic colours

The values above were measured from the reference texture and are **not** matched to Bambu colour codes. The table below finds, for each value, the closest PLA Basic colour in Lab space. It is only a guide for choosing filament.

- The Bambu values come from [a list compiled by forum users](https://forum.bambulab.com/t/color-picker-include-hex-codes-and-closest-bambu-color-code/171046), not from official data. Trust the filament in hand and the official site for the real colour.
- Only colour names are given, not codes: most colours in that list have no code, and I have not verified them. A wrong code would send someone to buy the wrong filament.
- Where the difference (ΔE) is above 15, PLA Basic has nothing really close. Print in white or Beige and paint it by hand.

| This project's colour | Value | Closest PLA Basic | ΔE |
|---|---|---|---|
| Grey | `#999996` | Gray | 4.4 |
| Mid grey | `#82827D` | Gray | 5.4 |
| Warm grey | `#80786B` | Gray | 10.3 |
| Dark grey | `#595952` | Dark Gray | 4.7 |
| Charcoal | `#424242` | Dark Gray | 7.7 |
| Lens grey | `#B2B5B2` | Silver | 4.9 |
| Light grey | `#B8BAB0` | Silver | 8.5 |
| Warm ivory | `#B2A696` | Silver | 11.0 |
| Bright red | `#C40A08` | Red | 11.7 |
| Black-grey (stand) | `#33363B` | Dark Gray | 13.7 |
| Dark brown | `#593D36` | Cocoa Brown | 14.8 |
| Dark red | `#7A2B26` | Brown | 15.2 |
| Steel blue | `#638599` | Blue Grey | 13.7 |
| Pale sage | `#B2B59E` | Silver | 13.5 |
| Green | `#52A624` | Bambu Green | 16.9 |
| Oxblood | `#5E3330` | Cocoa Brown | 17.9 |
| Ivory (head shell, torso and other large parts) | `#C9CFB0` | Light Gray or Beige | 17.7 / 18.1 |

There is no good match for the ivory of the large parts. Printing in Beige or Jade White and then spraying ivory is the safest route.

## Troubleshooting

- **Holes too tight**: the pin holes are 3.3 mm and the antenna holes 2.3 mm. If your printer swells holes shut, run a drill bit through them.
- **Inlays won't sit flat**: usually first-layer edge spread (elephant's foot). Shrink the first layer a little, or chamfer the bottom edge before fitting.
- **Thin inlays warp**: the 1 mm red and grey inlays curl first. Use a cooler bed and a brim, or print several thin inlays together in the middle of the bed.
- **Does the head shell need support?** By the geometric estimate, the head shell (on its side) has about 2600 mm² of overhang. The README says it needs "almost no support". The two disagree and neither has been checked by printing. Trust your slicer's preview, and print one to see.
- **Loose joints**: if a friction pin hole is too loose, use a slightly thicker pin, or smear a very small amount of glue on the pin without letting it bond.
