homalozoa/librebd1/CHANGELOG.md

# Changelog

All notable changes to this project are documented here. The format follows
[Keep a Changelog](https://keepachangelog.com/en/1.1.0/) and the project uses
[Semantic Versioning](https://semver.org/).

## [Unreleased]

### Changed

- Renamed the project from openbd1 to librebd1: repository, page, documentation and the Pages domain (`librebd1.haiwang.ai`). Old GitHub URLs redirect.

## [0.2.0] - 2026-10-30

First public release. The 0.1.0 that was only ever tagged locally was dropped and its
contents are folded in below.

### Added

- English versions of the docs: `README.en.md` and `PRINTING.en.md`, cross-linked with the Chinese ones.
- `PRINTING.md`: parts list with print orientation, assembly steps, and nearest Bambu PLA Basic colours.
- The 54 part STLs under `stl/`.
- `web/`: a scroll-directed Vite + three.js showpiece: shader sky, ringed planet and stars, a glowing landing pad, soft shadows, reflections and bloom around the real part meshes; it disperses into an exploded view, flies onto the print beds and highlights each assembly step as you scroll. Chinese and English (browser language by default, switchable, copy in `web/src/i18n.js`). Includes sci-fi epigraphs and a GitHub Pages workflow. `pack_web.py` precomputes creased normals and packs the data, `render_print_layout.py` renders the print orientations.
- MIT license for the scripts, CC BY-NC-SA 4.0 for the model files, and a fan-work notice in the README.

### Removed

- `compare_sheet.png` is no longer tracked: it shows the reference's textures.

### Model and tools (carried over from the dropped 0.1.0)

#### Added

- Parametric FreeCAD model (`bd1_model.py`) of BD-1, split into 54 parts by
  colour and joined with 3 mm pins and glue; `BD1_HEIGHT` scales it while pin
  holes and glue gaps keep their real size.
- Head: arched hood round a goggle-shaped face panel, eye barrels and lenses,
  arched cut-out under the nose and notch at the top, recessed green light
  panel on the back slope, ears revolved from the measured profile, antennas
  with a separate tapered collar.
- Torso: traced side, front and plan outlines with bevelled top edges,
  recessed chest plate, red tab, recessed back panel, hip recesses with a
  raised lip.
- Legs: tray-shaped thigh plates with a two-tone channel, threaded rod and
  threaded cylinder, layered knee bolt, shins with a raised red plate and two
  lugs, two-tone feet with slots and an ankle fork, and a hip hub that carries
  the hip pin.
- Paint: per-side head markings traced from the reference texture, and a
  palette whose colours are area-weighted means of the texture.
- Display stand, needed because the centre of mass is behind the heels.
- Tools: `glb_ref.py` (skinned, textured reference loader), `ref_profiles.py`
  (outline tracing), `heightmap.py` (mesh rasteriser), `render_views.py`,
  `compare.py` (outline IoU and band deviations), `depth_diff.py` (six-way
  surface comparison), `check_fit.py`, `export_stl.py`, `preview_gui.py`.

#### Fixed

- Ear centre refitted to (-28.3, 171.0); hood profile half-millimetre offset.
- Eye lens domes, left-eye barrel and lens ring, red band on the right barrel.
- Thigh edge bevel, knee centre and bolt profile, rod and cylinder axes.
- Torso plan taper, back corners, chest recess outline and chest tab position.
- Chin tabs, head underside corners, antenna line, light recess edges.

#### Known differences from the reference

- Deliberate, for printing: the hip hub (the reference's thighs float), glue
  gaps and pin holes, 0.4 mm floors in the foot slots, and the stand.
- Not representable: sub-millimetre sculpted detail and texture-only
  weathering (dirt, scratches, gradients, colour spots under about 3 mm).
