homalozoa/librebd1/(commit log)

2026-10-29 feat: modular BD-1 model measured from the reference mesh
    Parametric FreeCAD model of BD-1 split into colour parts joined by 3 mm pins.
    Head, torso, legs and neck follow outlines traced from the reference GLB; the
    face is a hood with a recessed panel; the thighs carry the red channel, rod
    and threaded cylinder. Includes scripts to export STLs, check fits, render
    orthographic views and compare them with the reference.
    [BD1.FCStd]
2026-10-29 feat(head): arched hood, goggle face panel, recessed light and ear relief
    - Snout is now an arched hood whose top plate sweeps down into thin side walls,
    round a face panel whose goggle-shaped lower edge runs into the chin tabs and
    opens into a slot between the eyes.
    - Arched cut-out under the nose and a notch at the top of the head's front face.
    - Red snout patches follow the curved hood walls.
    - Green light becomes a panel recessed 3 mm into the sloped back face.
    - Ear discs are revolved from the measured profile: rounded rim plus a grey
    centre with cone, annular groove, hub and dimple. Antenna socket shortened so
    it stays clear of the centre.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
2026-10-29 feat(torso): plan outline, recessed chest plate and back panel
    - Torso is also cut to its traced plan outline: sides taper towards the front
    and step out round the hip.
    - Grey chest plate now sits 5.2 mm behind the front face, as on the reference.
    - Back gets a 4 mm recessed panel with sloped edges.
2026-10-29 feat(legs): measured foot plate, slots and ankle fork
    Foot follows the reference's side profile (thin heel rising to 5.3 mm, sloped
    nose) with two through-slots; the ankle fork is two shaped side plates joined
    by a low cross block. Ankle pin moved to (39.3, 9.8) for wall round the hole.
2026-10-29 fix(head): refit ear centre and hood profile; stepped chest recess
    - Ear centre refitted to the rim's circle (-28.3, 171.0); the ear is now an
    outer ring plus a grey centre that sits against the head and carries the peg,
    with the deep annular groove the reference has.
    - Hood profile y values were sampled half a millimetre inboard; corrected.
    - Chest recess follows the reference's stepped outline.
    - depth_diff also saves its raw height maps for closer analysis.
2026-10-29 fix: match eye lens profiles, goggle corners, torso taper and thigh bevel
    - Right lens dome is 5 mm high; the left eye has no lip in its barrel and its
    centre feature is a raised ring round a shallow cup, as on the reference.
    - Slot between the goggle lobes widens under the hood's top plate.
    - Torso front corners taper as measured.
    - Thigh plate edge bevel increased to 1.5 mm.
2026-10-29 fix: traced raised patch in the thigh channel; taller back light recess
    - The nearly flush part of the red channel floor follows the patch traced from
    the reference instead of a horizontal cut.
    - Torso front corners use the reference's measured plan taper.
    - Back light recess reaches 1 mm higher, as measured.
2026-10-29 docs: describe the measured details and refresh previews
    README lists the new head, ear, torso, thigh and foot details, the depth_diff
    tool, updated pin and antenna lengths, the two-part ears, and the stand being
    required because the centre of mass is now behind the heels. Preview, colour
    assembly and comparison sheet regenerated.
    [BD1.FCStd]
2026-10-29 fix(legs): steep thigh edge bevel and layered knee bolt
    The reference thigh plate's outer face is 1.25 mm smaller than its outline all
    round, falling almost the full plate thickness at the edge; the plate is now a
    loft between the two outlines instead of a 1.5 mm 45-degree chamfer. The knee
    bolt is revolved from its measured profile (bevelled base, ring, boss, star
    socket) and sits in a wider pocket that leaves the groove seen on the
    reference. Adds a general revolve_y helper shared with the ears.
2026-10-29 fix(torso): bevel the top side edges and widen the back corners
    The reference torso's top-to-side edges are bevelled, more towards the front;
    a plane fitted to it (rms 0.45 mm) now cuts both corners. The plan outline's
    back corners reach y = 24.8 as measured. The head's chin tabs stop at
    |y| = 49 so no sliver hangs below the hood walls.
2026-10-29 feat(paint): per-side head markings, ear red line, two-tone thigh channel
    The reference texture paints BD-1's sides differently: the right side has a
    grey panel with a red dot, a high red stripe, a red front block, a red strip
    at the bottom of the back and the red snout patch; the left side has a lower
    red stripe and no panel or snout patch. Both carry a grey strip along the top
    edge. These are now separate inlays traced from the texture, replacing the
    symmetric panel, stripe and snout patch.
    The ears' red is a thin line on the flat rim, so the ring gets a 0.6 mm paint
    groove there. The thigh channel insert is split into the red raised patch and
    a dark floor (plus a small dark tip), matchin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
2026-10-29 docs: document per-side paint, thigh and knee detail; refresh previews
    README describes the asymmetric head markings and their part names, the
    two-tone thigh channel, the steep thigh bevel, the revolved knee bolt, the
    torso corner bevel and the ear's red-line groove, with the part count now 47.
    Preview, colour assembly and comparison sheet regenerated.
    [BD1.FCStd]
2026-10-29 fix(legs): fit the thigh rod, shank and threaded cylinder to the reference
    Axis end points, radii and tops come from circle fits to the reference's
    cross-sections: a 1.28 mm threaded rod and 2.35 mm shank on one 60-degree
    axis, and a 2.2 mm threaded cylinder whose thicker cap sits higher.
2026-10-29 fix(legs): tray-shaped thigh, hip recess and knee centre from the reference
    - The reference thigh plate is a shallow tray: hollow underneath (28.24) inside
    a rim that curls in to 26.36. The plate now matches; a hub hidden in the
    torso's hip recess carries the hip pin, since the reference parts float.
    - The torso side face is at 25.3 with a round recess round the hip; the 26.7
    values traced earlier were only the rim of that recess.
    - The knee joint moves to the knee bolt's fitted centre (-17.5, 72.0); the
    shin's knee boss now reaches into the thigh's hollow.
2026-10-29 fix: raised lip round the hip recess; sloped edges on the back light recess
    - The torso's hip recess has a 0.75 mm lip standing 1.35 mm proud, as on the
    reference; it is trimmed where the thigh's rim covers it so the parts don't
    collide. Recess floor lowered to 21.0.
    - The back light recess is lofted from its surface outline to a smaller floor,
    giving the sloped top and side edges the reference has (bottom edge stays
    sharp); the green insert lines the floor.
2026-10-29 fix: knee bolt groove and socket, hip lip clearance, foot slot floors
    - The knee bolt gets the narrow groove between its boss and ring; its socket is
    round (the star on the reference is only texture). Pocket narrowed to 9.9 so
    it no longer breaks through the thigh tray's edge.
    - The hip-recess lip is only lowered where it would touch the thigh's rim,
    rather than removed there.
    - The foot slots keep a 0.4 mm floor: on the reference they are closed at z 0.
2026-10-29 fix(head): start the chin tabs at x 50.6 as on the reference
    Seen from behind, the reference's chin tabs begin 1.4 mm further back than the
    snout; the extra strip below the head follows the same goggle outline.
2026-10-29 fix(head): fitted antenna line and tapered collar; lower underside
    - Antennas follow the line fitted to the reference (plane |y| = 59.48) and
    leave the ear through a 7 mm tapered collar (r 1.96 to 1.61) instead of a
    4.8 mm cylinder.
    - The head's underside is at 151.6, not 151.9.
    - Light recess floor and the torso back panel's sloped sides widened to the
    measured values.
2026-10-29 fix(paint): red band on the right eye barrel; chest tab position
    - The right eye's barrel is grey on the reference with a 1.5 mm red band on
    its front face (r 10.75 to 12.25); the barrel is now grey with that band as
    its own inlay.
    - The chest's red tab sits where the front face meets the top chamfer
    (z 121.4 to 124.9, 12.8 mm wide), as traced, instead of on the chamfer.
2026-10-29 feat(paint): measured palette; two-tone feet and a separate antenna collar
    Every colour is now the area-weighted mean of the reference texture on that
    surface instead of an eyeballed value: the shins are a warm grey, the thigh
    plate and ear ring a warmer off-white than the head, the shin plates, thigh
    patch and chest tab a dark red, the right eye barrel oxblood, the left barrel
    light grey, the channel floor dark brown.
    The feet are dark behind x = 40.5 and light in front, with a light ankle fork,
    so each foot is now two parts. The dark antenna collar is its own part that
    slides over the rod.
2026-10-29 feat(paint): grey patches on the hood walls
    Both hood walls carry a grey patch between the main head and the snout's red
    block (right side) or the front edge (left side), traced from the texture with
    its small vent holes left out.
2026-10-29 docs: measured palette with hex values, deliberate deviations, new parts
    README gains the measured colour table (hex values for buying paint), the new
    details (tray thigh, hip recess, fitted rod and antenna, knee groove, eye band,
    two-tone feet, hood grey patches), assembly for the antenna collar, split feet
    and hip hub, and separates deliberate print-driven deviations from what
    cannot be matched exactly. Part count is now 54; previews regenerated.
    [BD1.FCStd]
2026-10-29 chore(release): v0.1.0
    First release of the modular BD-1 model: 54 printable parts measured from the
    reference mesh, a texture-measured palette, and the measuring and comparison
    tools. Adds CHANGELOG.md and __version__ in bd1_model.py.
2026-10-29 docs(license): MIT for code, CC BY-NC-SA 4.0 for the model, fan-work notice
    The repo is going public. The scripts get MIT; the model files get a
    non-commercial share-alike license because BD-1 is Lucasfilm/Disney IP and
    prints must not be sold. compare_sheet.png shows the reference's textures,
    so it is untracked and ignored; compare.py regenerates it locally.
2026-10-29 feat(stl): publish the 54 exported part STLs
    The README and LICENSE-MODEL already cover the STLs, but stl/ was ignored, so
    a fresh clone could not be sliced without FreeCAD. They come from the
    author's own model, not from the reference mesh. Also ignore .DS_Store.
    [antenna_collar_left.stl, antenna_collar_right.stl, antenna_left.stl, antenna_right.stl, chest_plate.stl, chest_tab.stl, ear_centre_left.stl, ear_centre_right.stl]
2026-10-29 docs: add PRINTING.md with parts list, assembly steps and Bambu PLA colours
    A step-by-step guide was missing: the README only had short assembly and
    print notes. The Bambu table matches measured colours to the nearest PLA
    Basic colour by name only, because the hex list used is community-made and
    most colours there have no verified code.
2026-10-29 feat(docs): add an interactive Star Wars styled page over the real part meshes
    A static README cannot show how the 54 parts fit together or lie on the bed.
    The page loads welded, int16-quantised meshes (pack_web.py, 2 MB) into
    three.js: orbit, exploded view, a print-bed view using the least-overhang pose
    from render_print_layout.py, and assembly steps that highlight their parts.
2026-10-29 docs: regenerate the PRINTING.md parts table from computed print poses
    The old orientation column was written by hand and was wrong in places (the
    light panel is a 26 mm tall slab, not a 1 mm film). The table now comes from
    the least-overhang pose per part, with the layout images, and flags that the
    head shell may need supports, which disagrees with the README.
2026-10-29 feat(web): restyle the page after No Man's Sky and rewrite the copy
    Alien-sky gradient, glowing landing pad, hexagon colour swatches and a
    "discovery" panel for scanned parts. The Chinese copy is rewritten in a plain,
    exploratory voice, with short epigraphs by Clarke, Bradbury, Le Guin, Butler
    and Adams. Fonts are Exo 2 and Inter from npm; the footer links the repo.
2026-10-29 feat(web): rebuild the page as a scroll-directed 3D showpiece
    The previous page still looked cheap: a CSS sky, flat-shaded low-poly parts and
    a grid of identical glass cards. One full-screen WebGL canvas now draws a shader
    sky with stars, a ringed planet and moon, a glowing landing pad and soft
    shadows, with clearcoat parts lit by a sky-matched environment and bloom. Scroll
    drives the scenes: arrival, colour sampling, exploded view, print beds and
    step-by-step assembly. Scanned parts get an annotation tag.
    pack_web.py now precomputes creased normals so the page loads in half a second
    instead of seconds of CPU work in the browser.
2026-10-29 feat(web): add Chinese and English, switchable and remembered
    All page copy moved into web/src/i18n.js. The language follows the browser by
    default; a button in the top bar switches it and the choice is kept in
    localStorage. The English is written in the same plain voice rather than
    translated word for word. Dynamic parts (palette, plates, steps, the part tag)
    are rebuilt on switch.
2026-10-29 docs: add English README and printing guide
    The page is bilingual but the repository docs were Chinese only, so a reader
    arriving from the page's GitHub link had nothing to read. README.en.md and
    PRINTING.en.md mirror the Chinese files, with the parts table generated from
    the same data and a link between each pair.
2026-10-30 fix(web): stop the backdrop from strobing behind the droid
    The film grain was a fixed full-screen layer with mix-blend-mode: overlay and a
    stepped transform animation sitting on top of the WebGL canvas, which can make
    the whole backdrop flash on some GPUs. It is now static and unblended. HDR peaks
    that could set off the bloom pass are also lowered: dimmer environment
    softboxes, a less glossy lens clearcoat, calmer star twinkle and a higher bloom
    threshold. A ?debug query keeps the drawing buffer so frames can be sampled.
2026-10-30 fix(web): remove the dashed ground ring that shimmered when the camera moved
    Measured in the live page with a deterministic camera sweep (same path, 240
    frames, block-wise luminance jumps over 25): the dashed outer ring on the
    ground made 64 jump events up to a 99-level change; without it 14 events and 40
    remain. The cause is aliasing where the dashes are seen edge-on, not the bloom,
    the stars or the grain. The dashes are gone, the solid rings are now filtered by
    the pixel footprint, and a soft glow replaces the dashed look.
2026-10-30 fix(web): clamp HDR before bloom so a glossy glint cannot flash the canvas
    Scrolling made the whole canvas flash for a single frame. A headless scroll
    sweep (267 frames, camera not rotating) showed 25 one-frame brightness spikes of
    about +25 on the canvas mean; with the bloom pass off there were none. A glossy
    facet can catch a light for one frame at a brightness hundreds of times the
    screen's white, and bloom spreads that across a quarter of the canvas. The HDR
    range is now clamped to 3.0 before bloom (0 spikes in the same sweep), and the
    lens is a little less mirror-like. pack_web and the ?debug hook are unchanged
    apart from exposing frame() so a hidden tab can be stepped by hand.
    Co-Auth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
